bruinformula/mk11-shutdown-pcb/Shutdown-MX150L.step

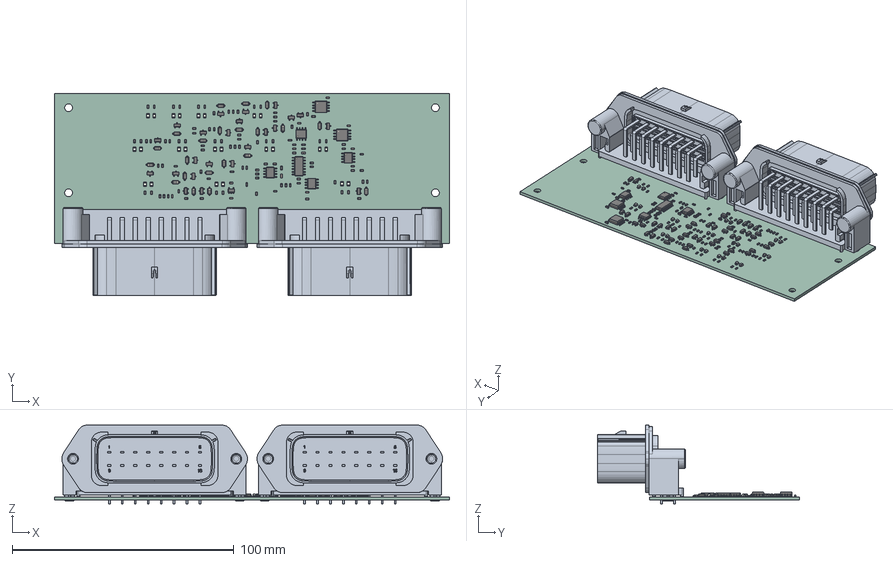
[picture p1: CAD file, 2026-02-07]
Shutdown-MX150L.step
178.3 x 91.0 x 35.6 mm
R_0603_1608Metric x 94
LED_0805_2012Metric x 24
D_SOD-123 x 21
SOT-23-3 x 23
SOIC-8_3.9x4.9mm_P1.27mm x 4
C_0603_1608Metric x 13
SOIC-14_3.9x8.7mm_P1.27mm
SOIC-8_5.3x5.3mm_P1.27mm x 2
SOT-23-5
Shutdown_PCB
