bruinformula/mk11-shutdown-pcb/Project-Libraries/3D Models/0194270049.stp

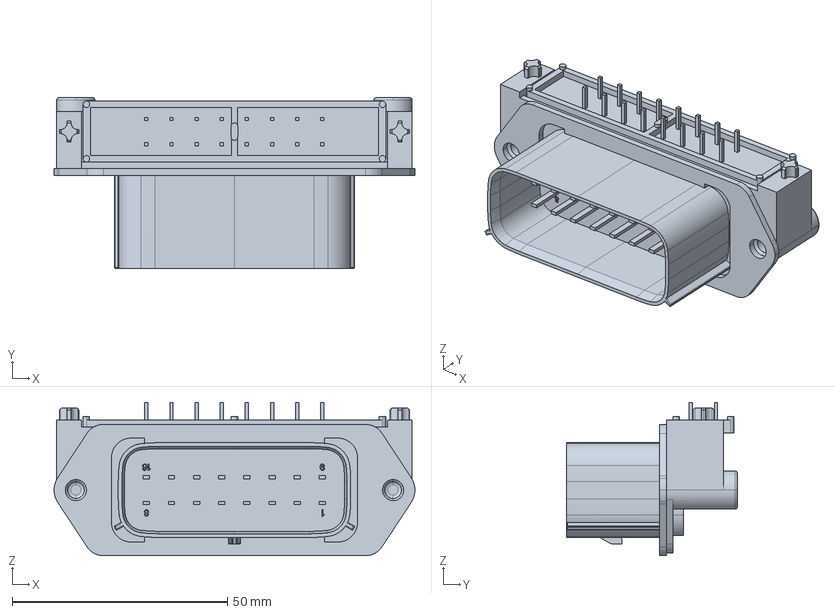
[picture p2: CAD file, 2026-02-07]
Project-Libraries/3D Models/0194270049.stp
83.8 x 39.6 x 35.6 mm
