bruinformula/mk11-shutdown-pcb/Project-Libraries/3D Models/348300801.stp

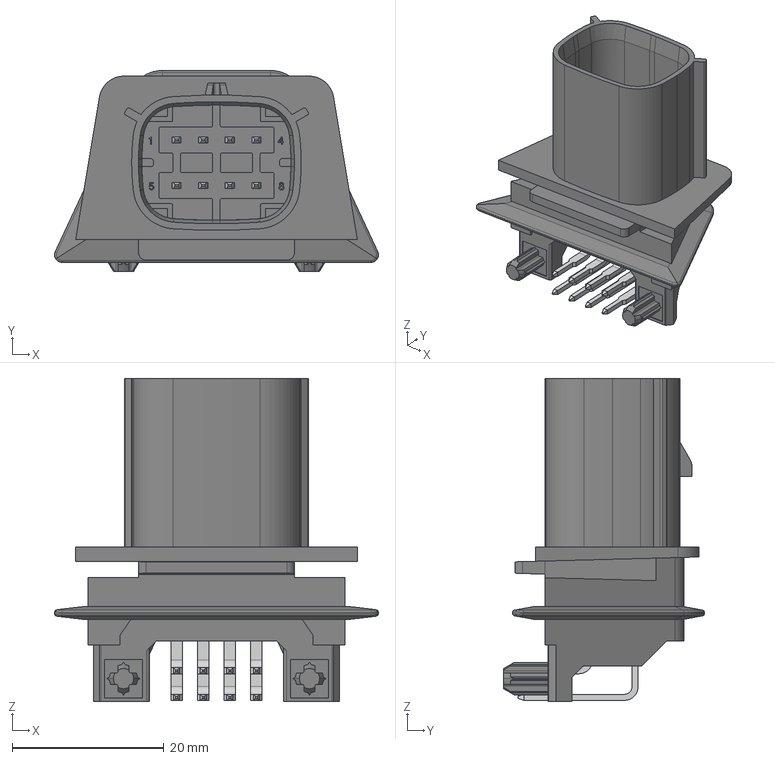
[picture p3: CAD file, 2025-10-08]
Project-Libraries/3D Models/348300801.stp
42.7 x 26.5 x 42.6 mm
