bruinformula/mk11-shutdown-pcb/Project-Libraries/3D Models/348302001.stp

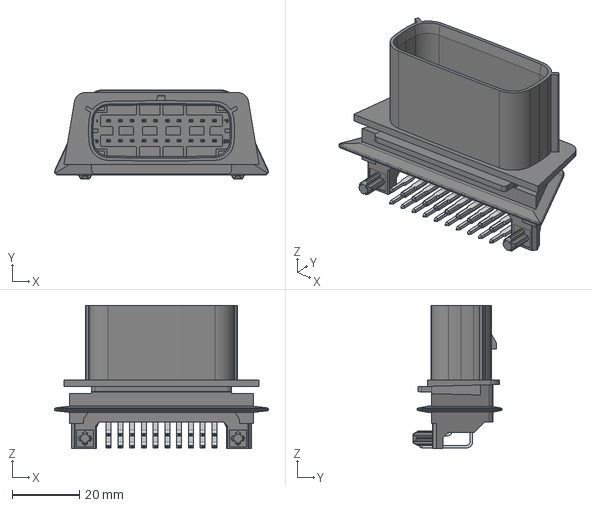
[picture p4: CAD file, 2025-10-08]
Project-Libraries/3D Models/348302001.stp
63.7 x 26.5 x 42.6 mm
