bruinformula/mk11-shutdown-pcb/Shutdown.kicad_pcb

## KiCad design Shutdown.kicad_pcb (2026-05-12)

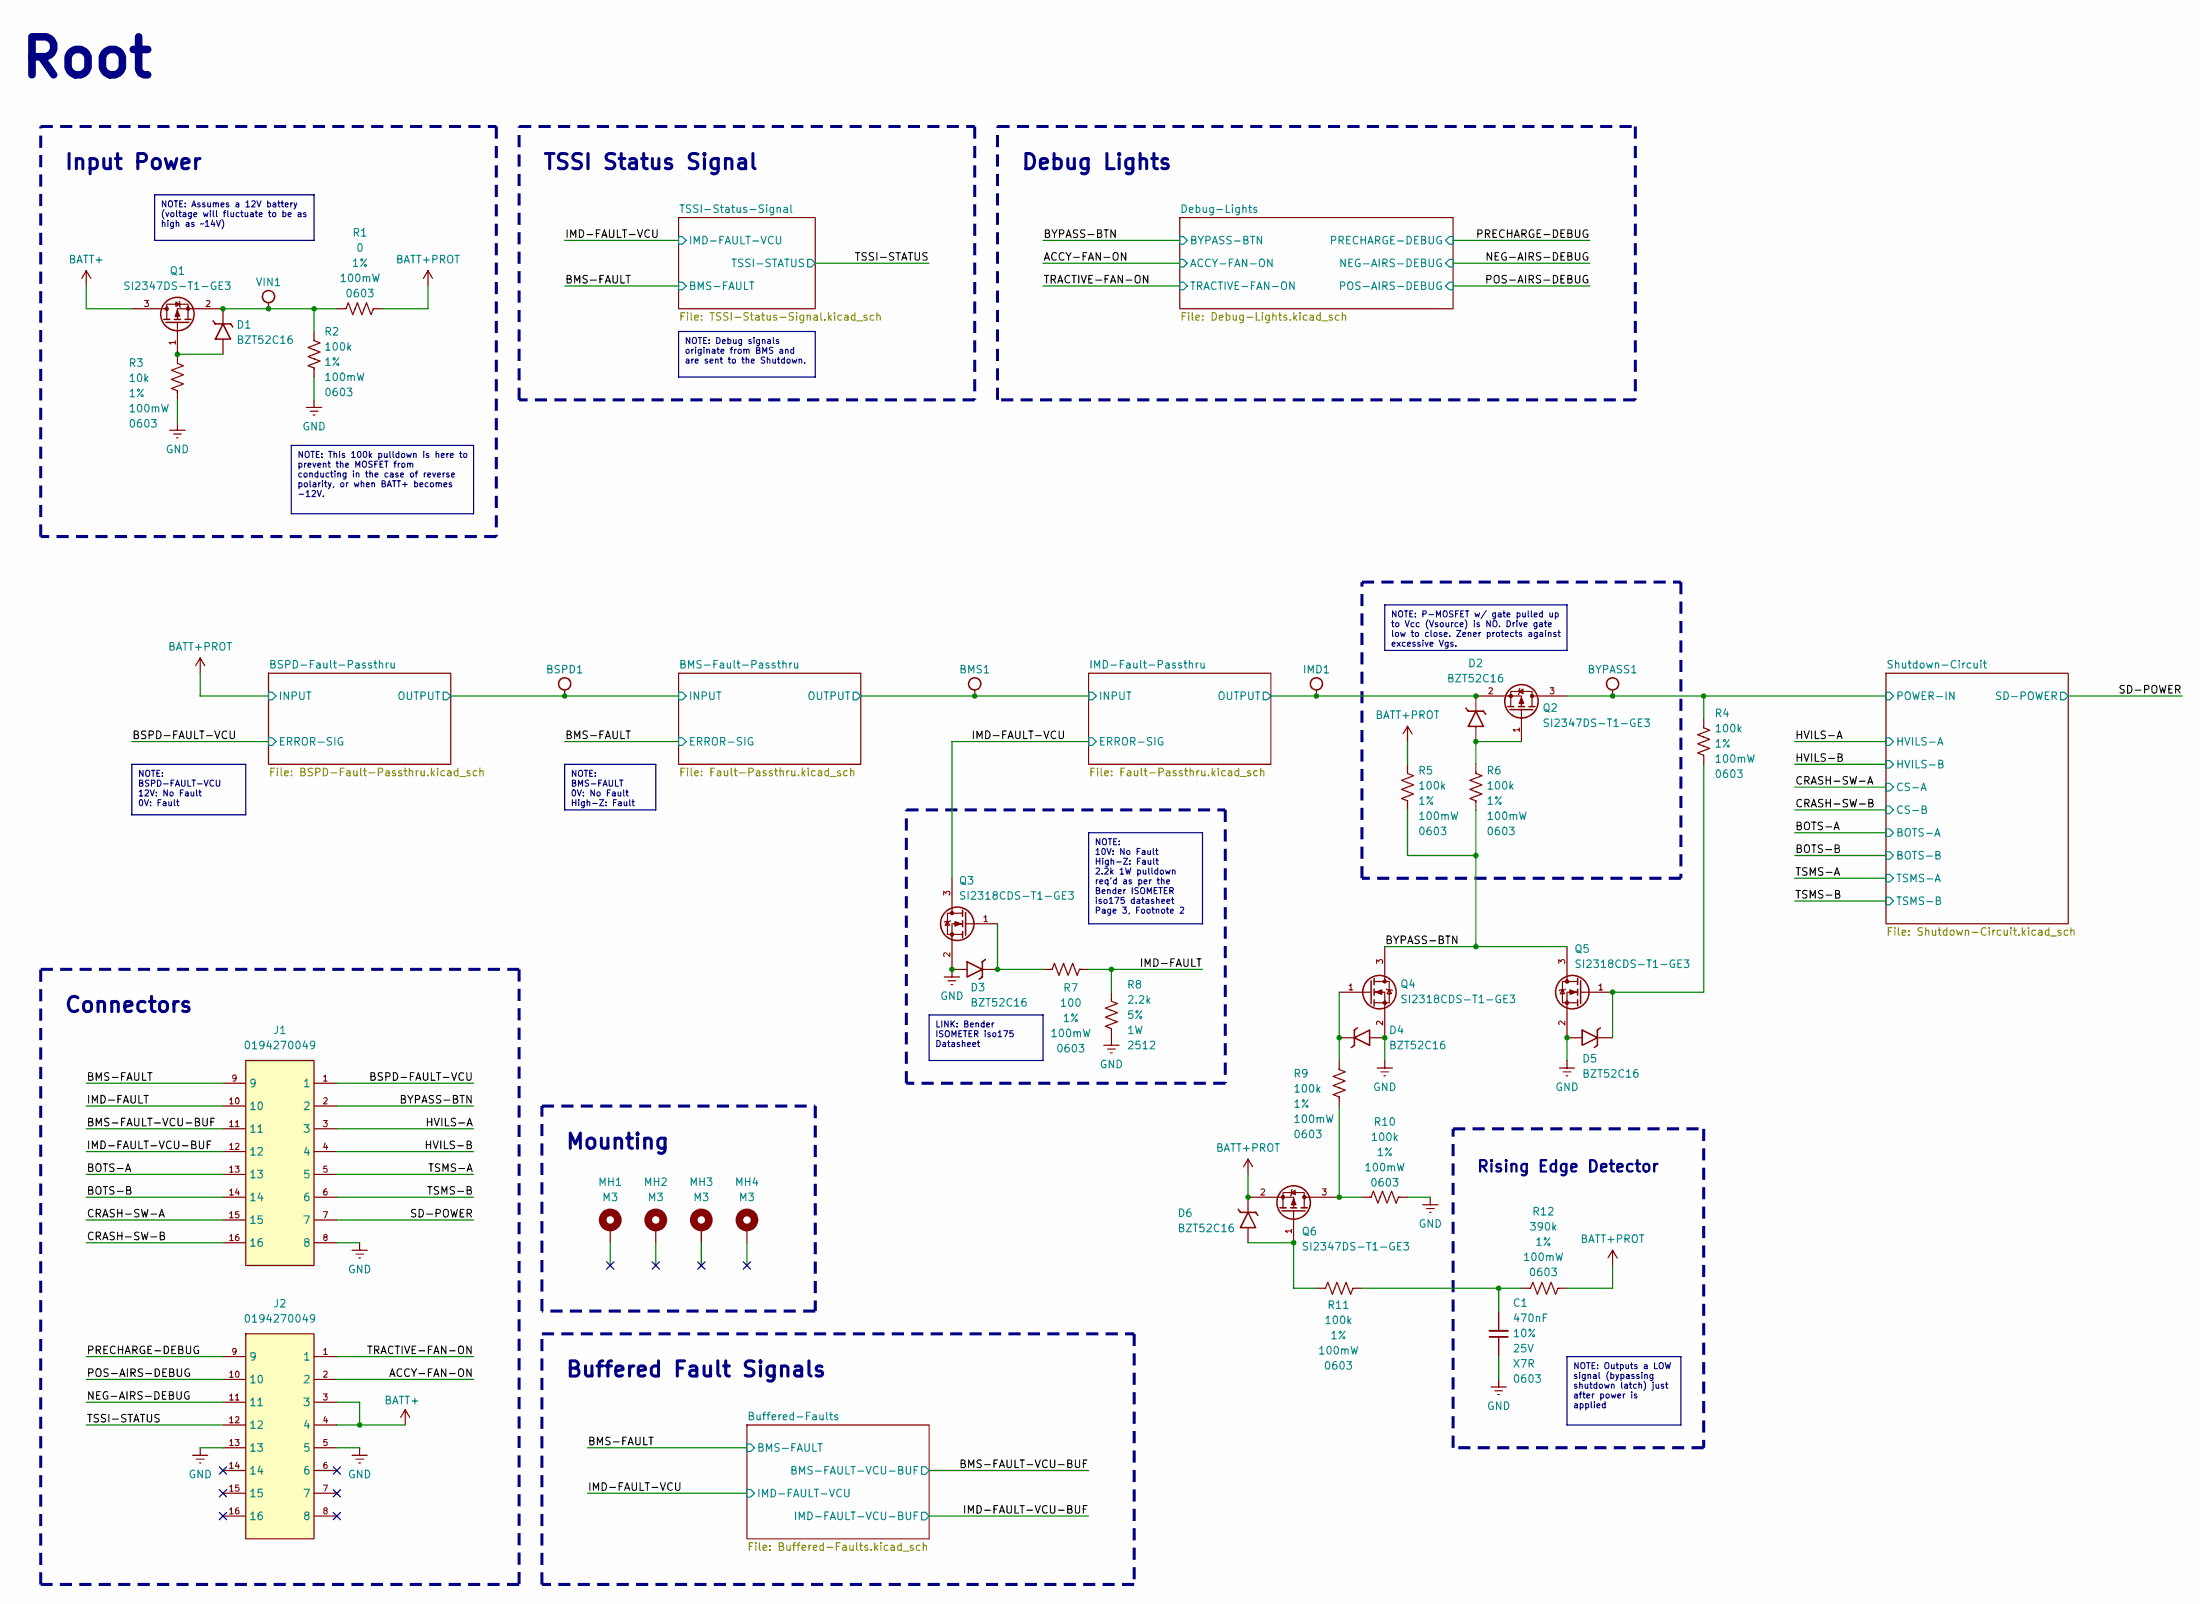
[picture p5: schematic Shutdown.kicad_sch]

Parts:
BMS1: TestPoint_Pad_1.0x1.0mm
BSPD1: TestPoint_Pad_1.0x1.0mm
BYPASS1: TestPoint_Pad_1.0x1.0mm
C1: 470nF; C_0603_1608Metric_Pad1.08x0.95mm_HandSolder; Tolerance 10%; Voltage 25V; Manufacturer P/N CL10B474KA8NNNC; Digikey P/N 1276-2083-1-ND
D1, D2, D3, D4, D5, D6: BZT52C16; D_SOD-123; Manufacturer P/N BZT52C16; Digikey P/N 4878-BZT52C16CT-ND
IMD1: TestPoint_Pad_1.0x1.0mm
J1, J2: 0194270049; Manufacturer P/N 0194270049; Digikey P/N WM7385-ND
MH1, MH2, MH3, MH4: MountingHole_3.5mm_Pad_TopBottom
Q1, Q2, Q6: SI2347DS-T1-GE3; SOT-23-3; Manufacturer P/N SI2347DS-T1-GE3; Digikey P/N SI2347DS-T1-GE3CT-ND
Q3, Q4, Q5: SI2318CDS-T1-GE3; SOT-23-3; Manufacturer P/N SI2318CDS-T1-GE3; Digikey P/N SI2318CDS-T1-GE3CT-ND
R1: 0; R_0603_1608Metric_Pad0.98x0.95mm_HandSolder; Tolerance 1%; Power Rating 100mW; Manufacturer P/N 0603WAF0000T5E; Digikey P/N 311-0.0GRCT-ND
R2, R4, R5, R6, R9, R10, R11: 100k; R_0603_1608Metric_Pad0.98x0.95mm_HandSolder; Tolerance 1%; Power Rating 100mW; Manufacturer P/N 0603WAF1003T5E; Digikey P/N RG16P100KBCT-ND
R3: 10k; R_0603_1608Metric_Pad0.98x0.95mm_HandSolder; Tolerance 1%; Power Rating 100mW; Manufacturer P/N 0603WAF1002T5E; Digikey P/N 541-10.0KHCT-ND
R7: 100; R_0603_1608Metric_Pad0.98x0.95mm_HandSolder; Tolerance 1%; Power Rating 100mW; Manufacturer P/N 0603WAF1000T5E; Digikey P/N 311-100HRCT-ND
R8: 2.2k; R_2512_6332Metric_Pad1.40x3.35mm_HandSolder; Tolerance 5%; Power Rating 1W; Manufacturer P/N FRC2512J222 TS; Digikey P/N RMCF2512JT2K20CT-ND
R12: 390k; R_0603_1608Metric_Pad0.98x0.95mm_HandSolder; Tolerance 1%; Power Rating 100mW; Manufacturer P/N 0603WAF3903T5E; Digikey P/N 311-390KHRCT-ND
VIN1: TestPoint_Pad_1.0x1.0mm

Connections:
/ACCY-FAN-ON: J2.2; also elsewhere on the board
/BMS-FAULT: J1.9; also elsewhere on the board
/BMS-FAULT-VCU-BUF: J1.11; also elsewhere on the board
/BMS-Fault-Passthru/INPUT: BSPD1.1 (1_1); also elsewhere on the board
/BMS-Fault-Passthru/OUTPUT: BMS1.1 (1_1); also elsewhere on the board
/BOTS-A: J1.13, J1.16; also elsewhere on the board
/BOTS-B: J1.5, J1.14; also elsewhere on the board
/BSPD-FAULT-VCU: J1.1; also elsewhere on the board
/BYPASS-BTN: J1.2, Q4.3 (D), Q5.3 (D), R5.1, R6.1; also elsewhere on the board
/CRASH-SW-A: J1.4, J1.15; also elsewhere on the board
/HVILS-A: BYPASS1.1 (1_1), J1.3, Q2.3 (D), R4.2; also elsewhere on the board
/IMD-FAULT: J1.10, R7.2, R8.2
/IMD-FAULT-VCU: Q3.3 (D); also elsewhere on the board
/IMD-FAULT-VCU-BUF: J1.12; also elsewhere on the board
/IMD-Fault-Passthru/OUTPUT: D2.1 (K), IMD1.1 (1_1), Q2.2 (S); also elsewhere on the board
/NEG-AIRS-DEBUG: J2.11; also elsewhere on the board
/POS-AIRS-DEBUG: J2.10; also elsewhere on the board
/PRECHARGE-DEBUG: J2.9; also elsewhere on the board
/SD-POWER: J1.6, J1.7; also elsewhere on the board
/TRACTIVE-FAN-ON: J2.1; also elsewhere on the board
/TSSI-STATUS: J2.12; also elsewhere on the board
BATT+: J2.3, J2.4, Q1.3 (D); also elsewhere on the board
BATT+PROT: D6.1 (K), Q6.2 (S), R1.2, R5.2, R12.2; also elsewhere on the board
GND: C1.1, D3.2 (A), D4.2 (A), D5.2 (A), J1.8, J2.5, J2.13, Q3.2 (S), Q4.2 (S), Q5.2 (S), R2.1, R3.1, R8.1, R10.2; also elsewhere on the board
unnamed: C1.2, R11.2, R12.1
unnamed: D1.2 (A), Q1.1 (G), R3.2
unnamed: D1.1 (K), Q1.2 (S), R1.1, R2.2, VIN1.1 (1_1)
unnamed: D2.2 (A), Q2.1 (G), R6.2
unnamed: D3.1 (K), Q3.1 (G), R7.1
unnamed: D4.1 (K), Q4.1 (G), R9.2
unnamed: D5.1 (K), Q5.1 (G), R4.1
unnamed: D6.2 (A), Q6.1 (G), R11.1
unnamed: Q6.3 (D), R9.1, R10.1

Notes on the sheet:
Buffered Fault Signals
Input Power
Rising Edge Detector
Debug Lights
Root
Mounting
TSSI Status Signal
Connectors
LINK: Bender ISOMETER iso175 Datasheet
NOTE: This 100k pulldown is here to prevent the MOSFET from conducting in the case of reverse polarity, or when BATT+ becomes -12V.
NOTE: Assumes a 12V battery (voltage will fluctuate to be as high as ~14V)
NOTE: Debug signals originate from BMS and are sent to the Shutdown.
NOTE: P-MOSFET w/ gate pulled up to Vcc (Vsource) is NO. Drive gate low to close. Zener protects against excessive Vgs.
NOTE: BSPD-FAULT-VCU 12V: No Fault 0V: Fault
NOTE: BMS-FAULT 0V: No Fault High-Z: Fault
NOTE: Outputs a LOW signal (bypassing shutdown latch) just after power is applied
NOTE: 10V: No Fault High-Z: Fault 2.2k 1W pulldown req'd as per the Bender ISOMETER iso175 datasheet Page 3, Footnote 2

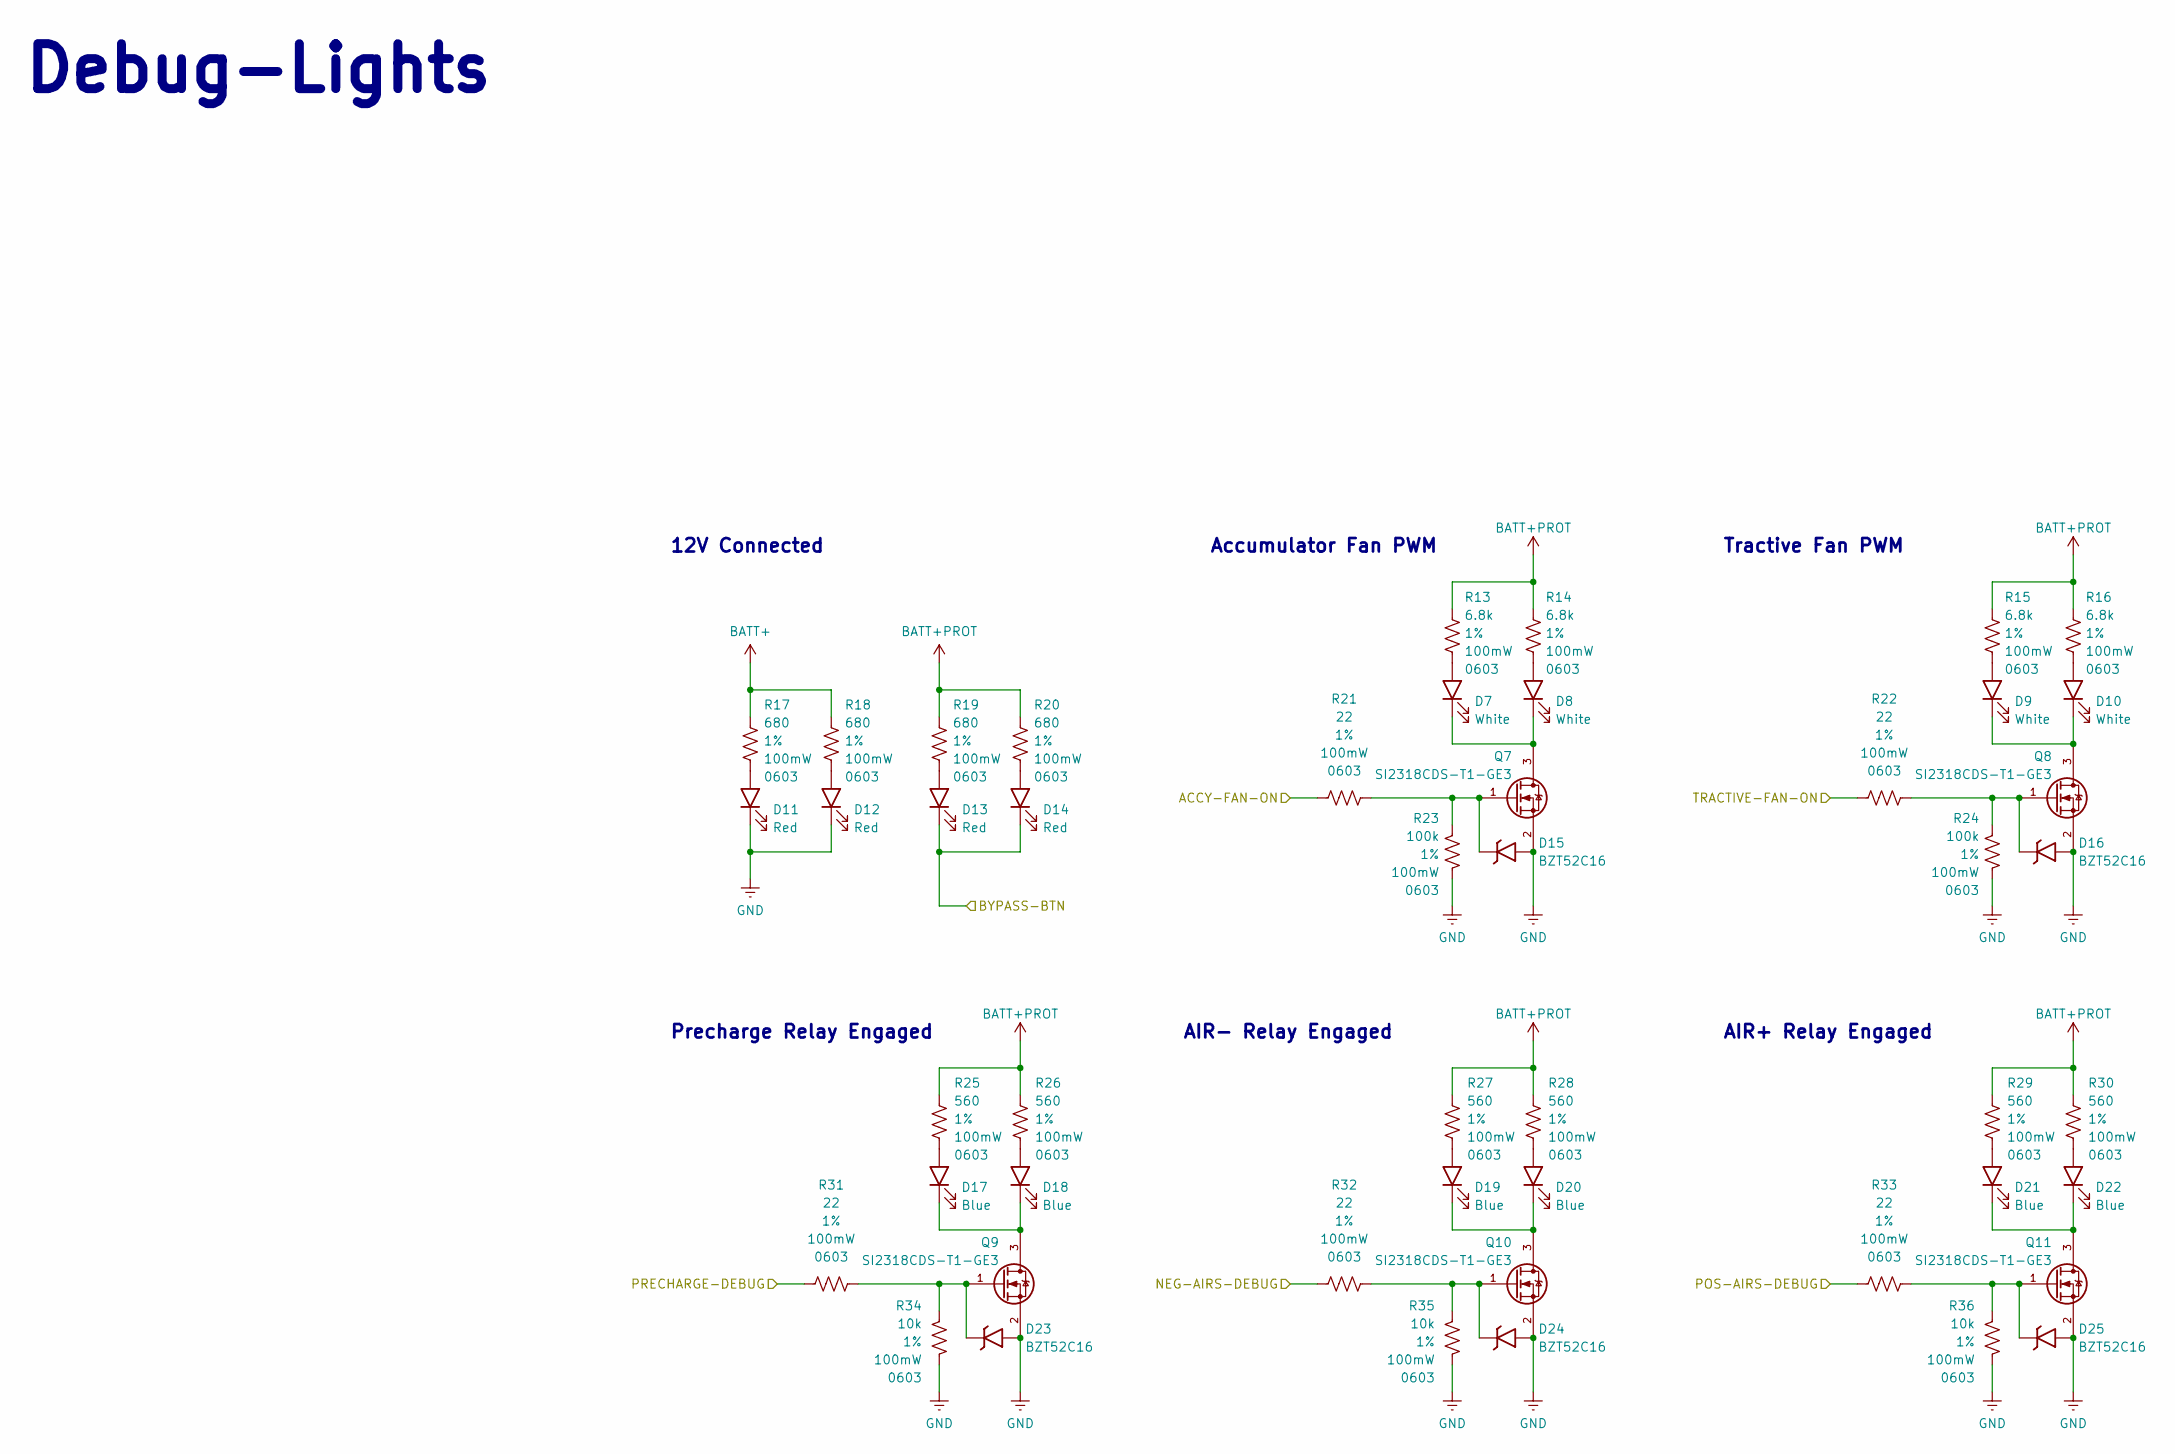
[picture p6: schematic Debug-Lights.kicad_sch]

Parts:
D7, D8, D9, D10: White; LED_0805_2012Metric; Manufacturer P/N KT-0805W; Digikey P/N 160-1738-1-ND
D11, D12, D13, D14: Red; LED_0805_2012Metric; Manufacturer P/N NCD0805R1; Digikey P/N 160-1427-1-ND
D15, D16, D23, D24, D25: BZT52C16; D_SOD-123; Manufacturer P/N BZT52C16; Digikey P/N 4878-BZT52C16CT-ND
D17, D18, D19, D20, D21, D22: Blue; LED_0805_2012Metric; Manufacturer P/N NCD0805B2; Digikey P/N 160-1579-1-ND
Q7, Q8, Q9, Q10, Q11: SI2318CDS-T1-GE3; SOT-23-3; Manufacturer P/N SI2318CDS-T1-GE3; Digikey P/N SI2318CDS-T1-GE3CT-ND
R13, R14, R15, R16: 6.8k; R_0603_1608Metric_Pad0.98x0.95mm_HandSolder; Tolerance 1%; Power Rating 100mW; Manufacturer P/N 0603WAF6801T5E; Digikey P/N 311-6.80KHRCT-ND
R17, R18, R19, R20: 680; R_0603_1608Metric_Pad0.98x0.95mm_HandSolder; Tolerance 1%; Power Rating 100mW; Manufacturer P/N 0603WAF6800T5E; Digikey P/N 311-680GRCT-ND
R21, R22, R31, R32, R33: 22; R_0603_1608Metric_Pad0.98x0.95mm_HandSolder; Tolerance 1%; Power Rating 100mW; Manufacturer P/N 0603WAF220JT5E; Digikey P/N 13-RC0603FR-1322RLCT-ND
R23, R24: 100k; R_0603_1608Metric_Pad0.98x0.95mm_HandSolder; Tolerance 1%; Power Rating 100mW; Manufacturer P/N 0603WAF1003T5E; Digikey P/N RG16P100KBCT-ND
R25, R26, R27, R28, R29, R30: 560; R_0603_1608Metric_Pad0.98x0.95mm_HandSolder; Tolerance 1%; Power Rating 100mW; Manufacturer P/N 0603WAF5600T5E; Digikey P/N 311-560HRCT-ND
R34, R35, R36: 10k; R_0603_1608Metric_Pad0.98x0.95mm_HandSolder; Tolerance 1%; Power Rating 100mW; Manufacturer P/N 0603WAF1002T5E; Digikey P/N 541-10.0KHCT-ND

Connections:
/ACCY-FAN-ON: R21.1; also elsewhere on the board
/BYPASS-BTN: D13.1 (K), D14.1 (K); also elsewhere on the board
/NEG-AIRS-DEBUG: R32.1; also elsewhere on the board
/POS-AIRS-DEBUG: R33.1; also elsewhere on the board
/PRECHARGE-DEBUG: R31.1; also elsewhere on the board
/TRACTIVE-FAN-ON: R22.1; also elsewhere on the board
BATT+: R17.2, R18.2; also elsewhere on the board
BATT+PROT: R13.2, R14.2, R15.2, R16.2, R19.2, R20.2, R25.2, R26.2, R27.2, R28.2, R29.2, R30.2; also elsewhere on the board
GND: D11.1 (K), D12.1 (K), D15.2 (A), D16.2 (A), D23.2 (A), D24.2 (A), D25.2 (A), Q7.2 (S), Q8.2 (S), Q9.2 (S), Q10.2 (S), Q11.2 (S), R23.1, R24.1, R34.1, R35.1, R36.1; also elsewhere on the board
unnamed: D7.2 (A), R13.1
unnamed: D7.1 (K), D8.1 (K), Q7.3 (D)
unnamed: D8.2 (A), R14.1
unnamed: D9.2 (A), R15.1
unnamed: D10.2 (A), R16.1
unnamed: D9.1 (K), D10.1 (K), Q8.3 (D)
unnamed: D11.2 (A), R17.1
unnamed: D12.2 (A), R18.1
unnamed: D13.2 (A), R19.1
unnamed: D14.2 (A), R20.1
unnamed: D15.1 (K), Q7.1 (G), R21.2, R23.2
unnamed: D16.1 (K), Q8.1 (G), R22.2, R24.2
unnamed: D17.2 (A), R25.1
unnamed: D17.1 (K), D18.1 (K), Q9.3 (D)
unnamed: D18.2 (A), R26.1
unnamed: D19.2 (A), R27.1
unnamed: D19.1 (K), D20.1 (K), Q10.3 (D)
unnamed: D20.2 (A), R28.1
unnamed: D21.2 (A), R29.1
unnamed: D21.1 (K), D22.1 (K), Q11.3 (D)
unnamed: D22.2 (A), R30.1
unnamed: D23.1 (K), Q9.1 (G), R31.2, R34.2
unnamed: D24.1 (K), Q10.1 (G), R32.2, R35.2
unnamed: D25.1 (K), Q11.1 (G), R33.2, R36.2

Notes on the sheet:
Debug-Lights
AIR+ Relay Engaged
Accumulator Fan PWM
Tractive Fan PWM
12V Connected
AIR- Relay Engaged
Precharge Relay Engaged

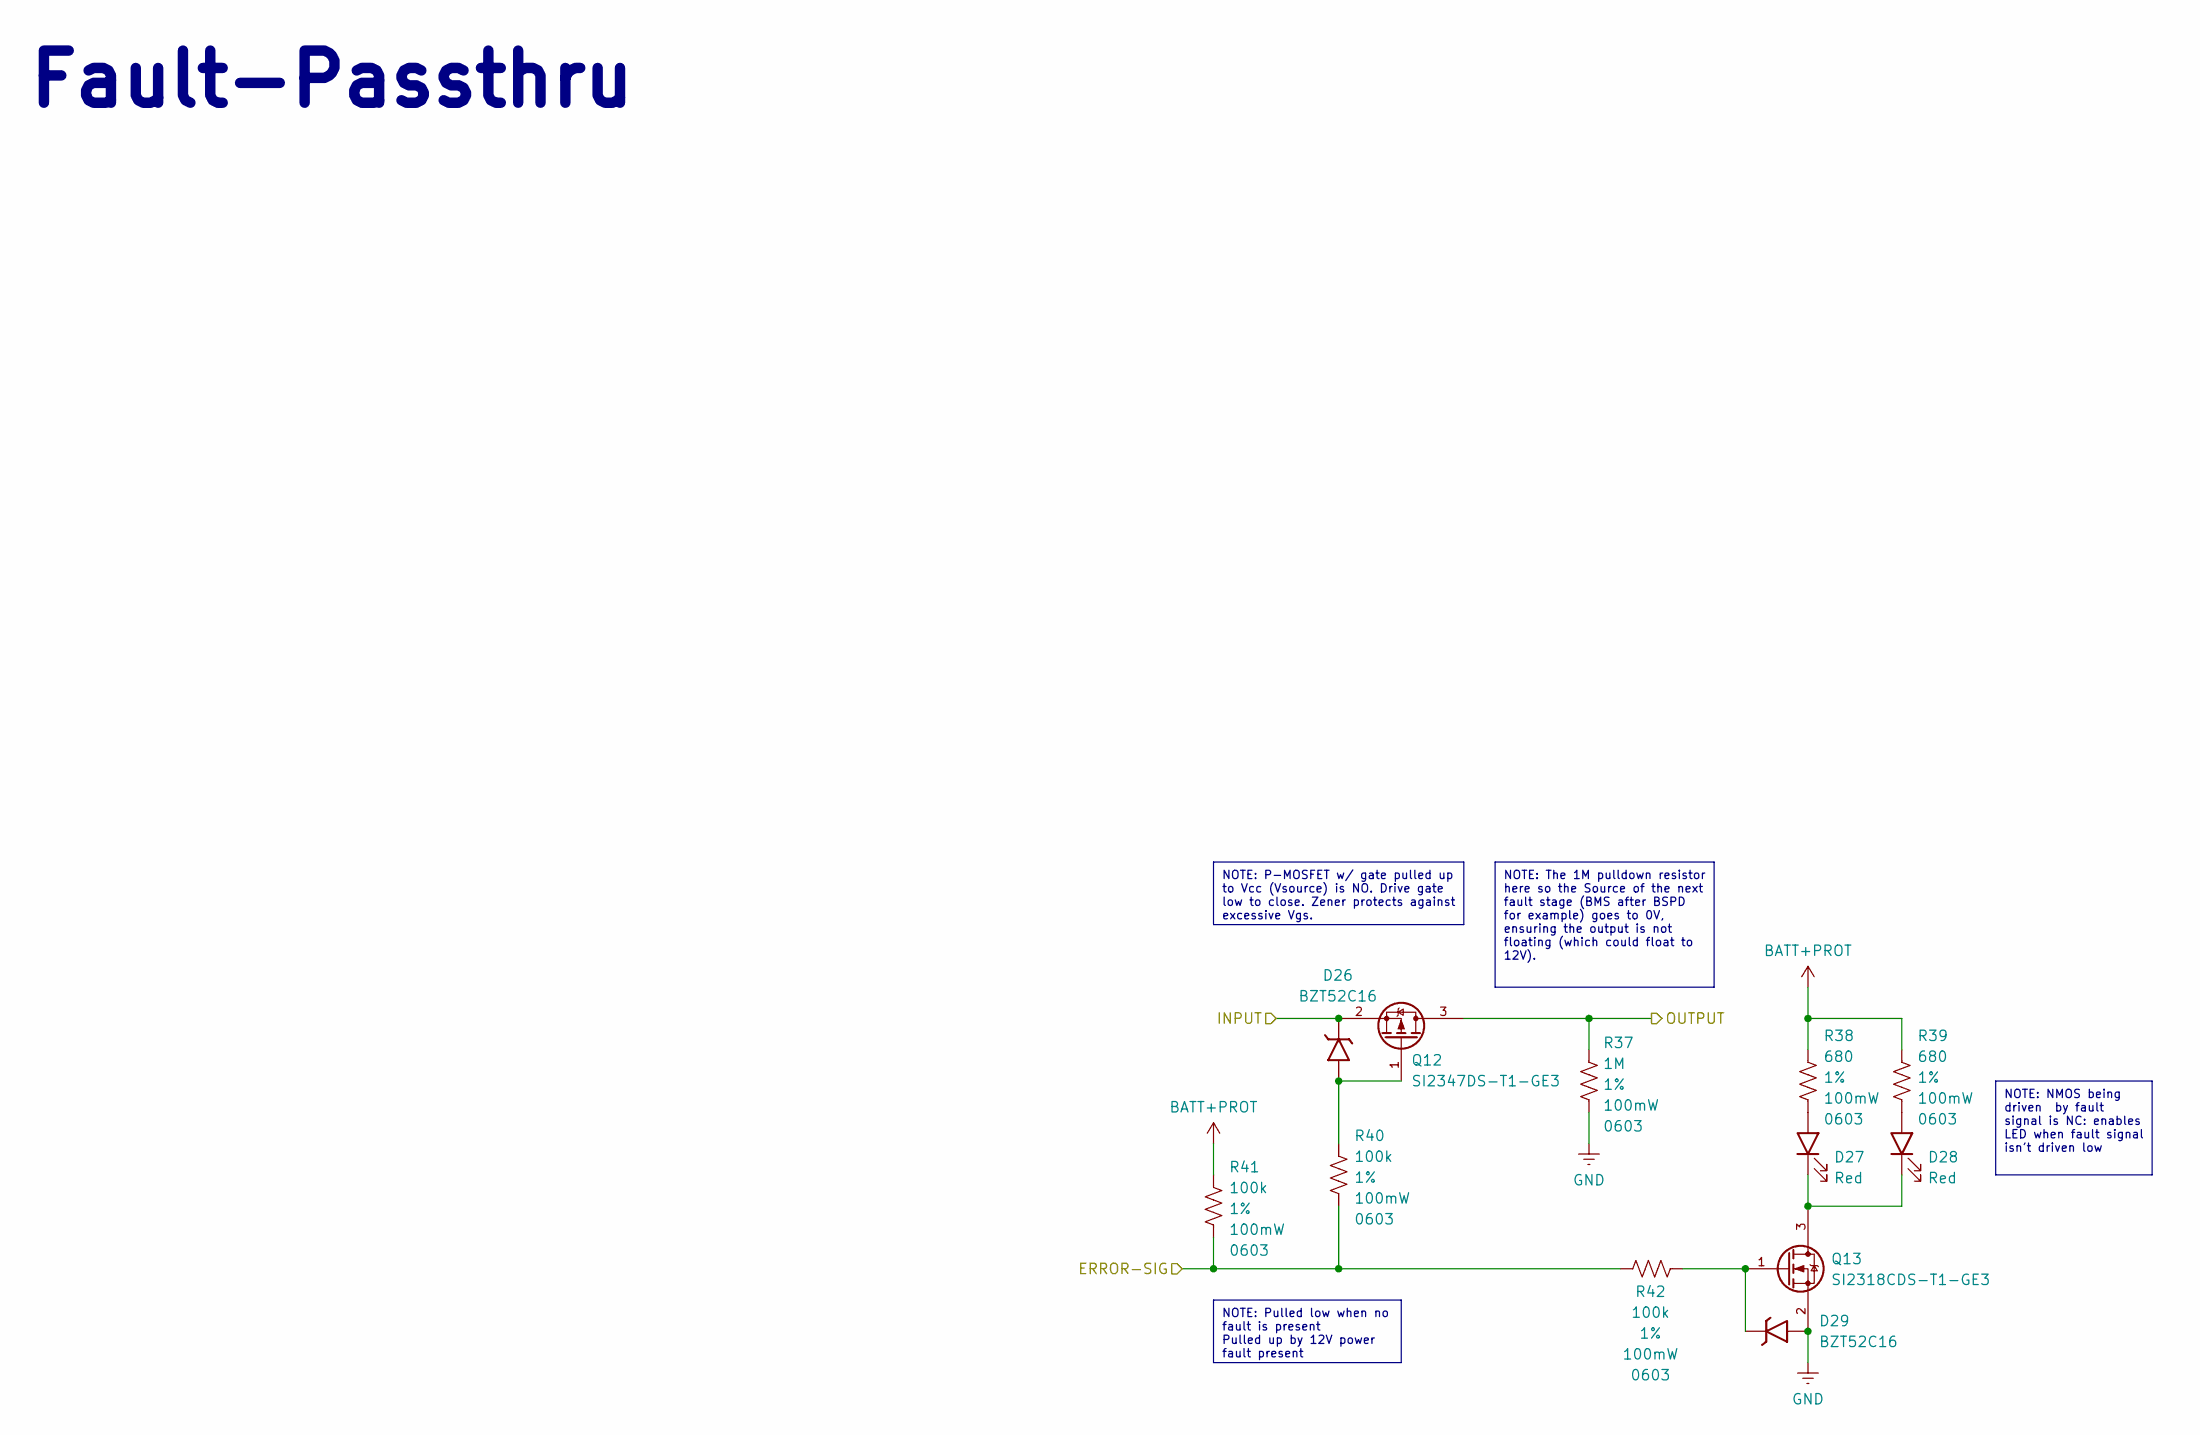
[picture p7: schematic Fault-Passthru.kicad_sch]

Parts:
D26, D29: BZT52C16; D_SOD-123; Manufacturer P/N BZT52C16; Digikey P/N 4878-BZT52C16CT-ND
D27, D28: Red; LED_0805_2012Metric; Manufacturer P/N NCD0805R1; Digikey P/N 160-1427-1-ND
Q12: SI2347DS-T1-GE3; SOT-23-3; Manufacturer P/N SI2347DS-T1-GE3; Digikey P/N SI2347DS-T1-GE3CT-ND
Q13: SI2318CDS-T1-GE3; SOT-23-3; Manufacturer P/N SI2318CDS-T1-GE3; Digikey P/N SI2318CDS-T1-GE3CT-ND
R37: 1M; R_0603_1608Metric_Pad0.98x0.95mm_HandSolder; Tolerance 1%; Power Rating 100mW; Manufacturer P/N 0603WAF1004T5E; Digikey P/N YAG4498CT-ND
R38, R39: 680; R_0603_1608Metric_Pad0.98x0.95mm_HandSolder; Tolerance 1%; Power Rating 100mW; Manufacturer P/N 0603WAF6800T5E; Digikey P/N 311-680GRCT-ND
R40, R41, R42: 100k; R_0603_1608Metric_Pad0.98x0.95mm_HandSolder; Tolerance 1%; Power Rating 100mW; Manufacturer P/N 0603WAF1003T5E; Digikey P/N RG16P100KBCT-ND

Connections:
/BMS-FAULT: R40.1, R41.1, R42.1; also elsewhere on the board
/BMS-Fault-Passthru/INPUT: D26.1 (K), Q12.2 (S); also elsewhere on the board
/BMS-Fault-Passthru/OUTPUT: Q12.3 (D), R37.2; also elsewhere on the board
BATT+PROT: R38.2, R39.2, R41.2; also elsewhere on the board
GND: D29.2 (A), Q13.2 (S), R37.1; also elsewhere on the board
unnamed: D26.2 (A), Q12.1 (G), R40.2
unnamed: D27.2 (A), R38.1
unnamed: D27.1 (K), D28.1 (K), Q13.3 (D)
unnamed: D28.2 (A), R39.1
unnamed: D29.1 (K), Q13.1 (G), R42.2

Parts of its further copies:
D30, D33: BZT52C16; D_SOD-123; Manufacturer P/N BZT52C16; Digikey P/N 4878-BZT52C16CT-ND
D31, D32: Red; LED_0805_2012Metric; Manufacturer P/N NCD0805R1; Digikey P/N 160-1427-1-ND
Q14: SI2347DS-T1-GE3; SOT-23-3; Manufacturer P/N SI2347DS-T1-GE3; Digikey P/N SI2347DS-T1-GE3CT-ND
Q15: SI2318CDS-T1-GE3; SOT-23-3; Manufacturer P/N SI2318CDS-T1-GE3; Digikey P/N SI2318CDS-T1-GE3CT-ND
R43: 1M; R_0603_1608Metric_Pad0.98x0.95mm_HandSolder; Tolerance 1%; Power Rating 100mW; Manufacturer P/N 0603WAF1004T5E; Digikey P/N YAG4498CT-ND
R44, R45: 680; R_0603_1608Metric_Pad0.98x0.95mm_HandSolder; Tolerance 1%; Power Rating 100mW; Manufacturer P/N 0603WAF6800T5E; Digikey P/N 311-680GRCT-ND
R46, R47, R48: 100k; R_0603_1608Metric_Pad0.98x0.95mm_HandSolder; Tolerance 1%; Power Rating 100mW; Manufacturer P/N 0603WAF1003T5E; Digikey P/N RG16P100KBCT-ND

Connections of its further copies:
/BMS-Fault-Passthru/OUTPUT: D30.1 (K), Q14.2 (S); also elsewhere on the board
/IMD-FAULT-VCU: R46.1, R47.1, R48.1; also elsewhere on the board
/IMD-Fault-Passthru/OUTPUT: Q14.3 (D), R43.2; also elsewhere on the board
BATT+PROT: R44.2, R45.2, R47.2; also elsewhere on the board
GND: D33.2 (A), Q15.2 (S), R43.1; also elsewhere on the board
unnamed: D30.2 (A), Q14.1 (G), R46.2
unnamed: D31.2 (A), R44.1
unnamed: D31.1 (K), D32.1 (K), Q15.3 (D)
unnamed: D32.2 (A), R45.1
unnamed: D33.1 (K), Q15.1 (G), R48.2

Notes on the sheet:
Fault-Passthru
NOTE: Pulled low when no fault is present Pulled up by 12V power fault present
NOTE: The 1M pulldown resistor here so the Source of the next fault stage (BMS after BSPD for example) goes to 0V, ensuring the output is not floating (which could float to 12V).
NOTE: NMOS being driven by fault signal is NC: enables LED when fault signal isn't driven low
NOTE: P-MOSFET w/ gate pulled up to Vcc (Vsource) is NO. Drive gate low to close. Zener protects against excessive Vgs.

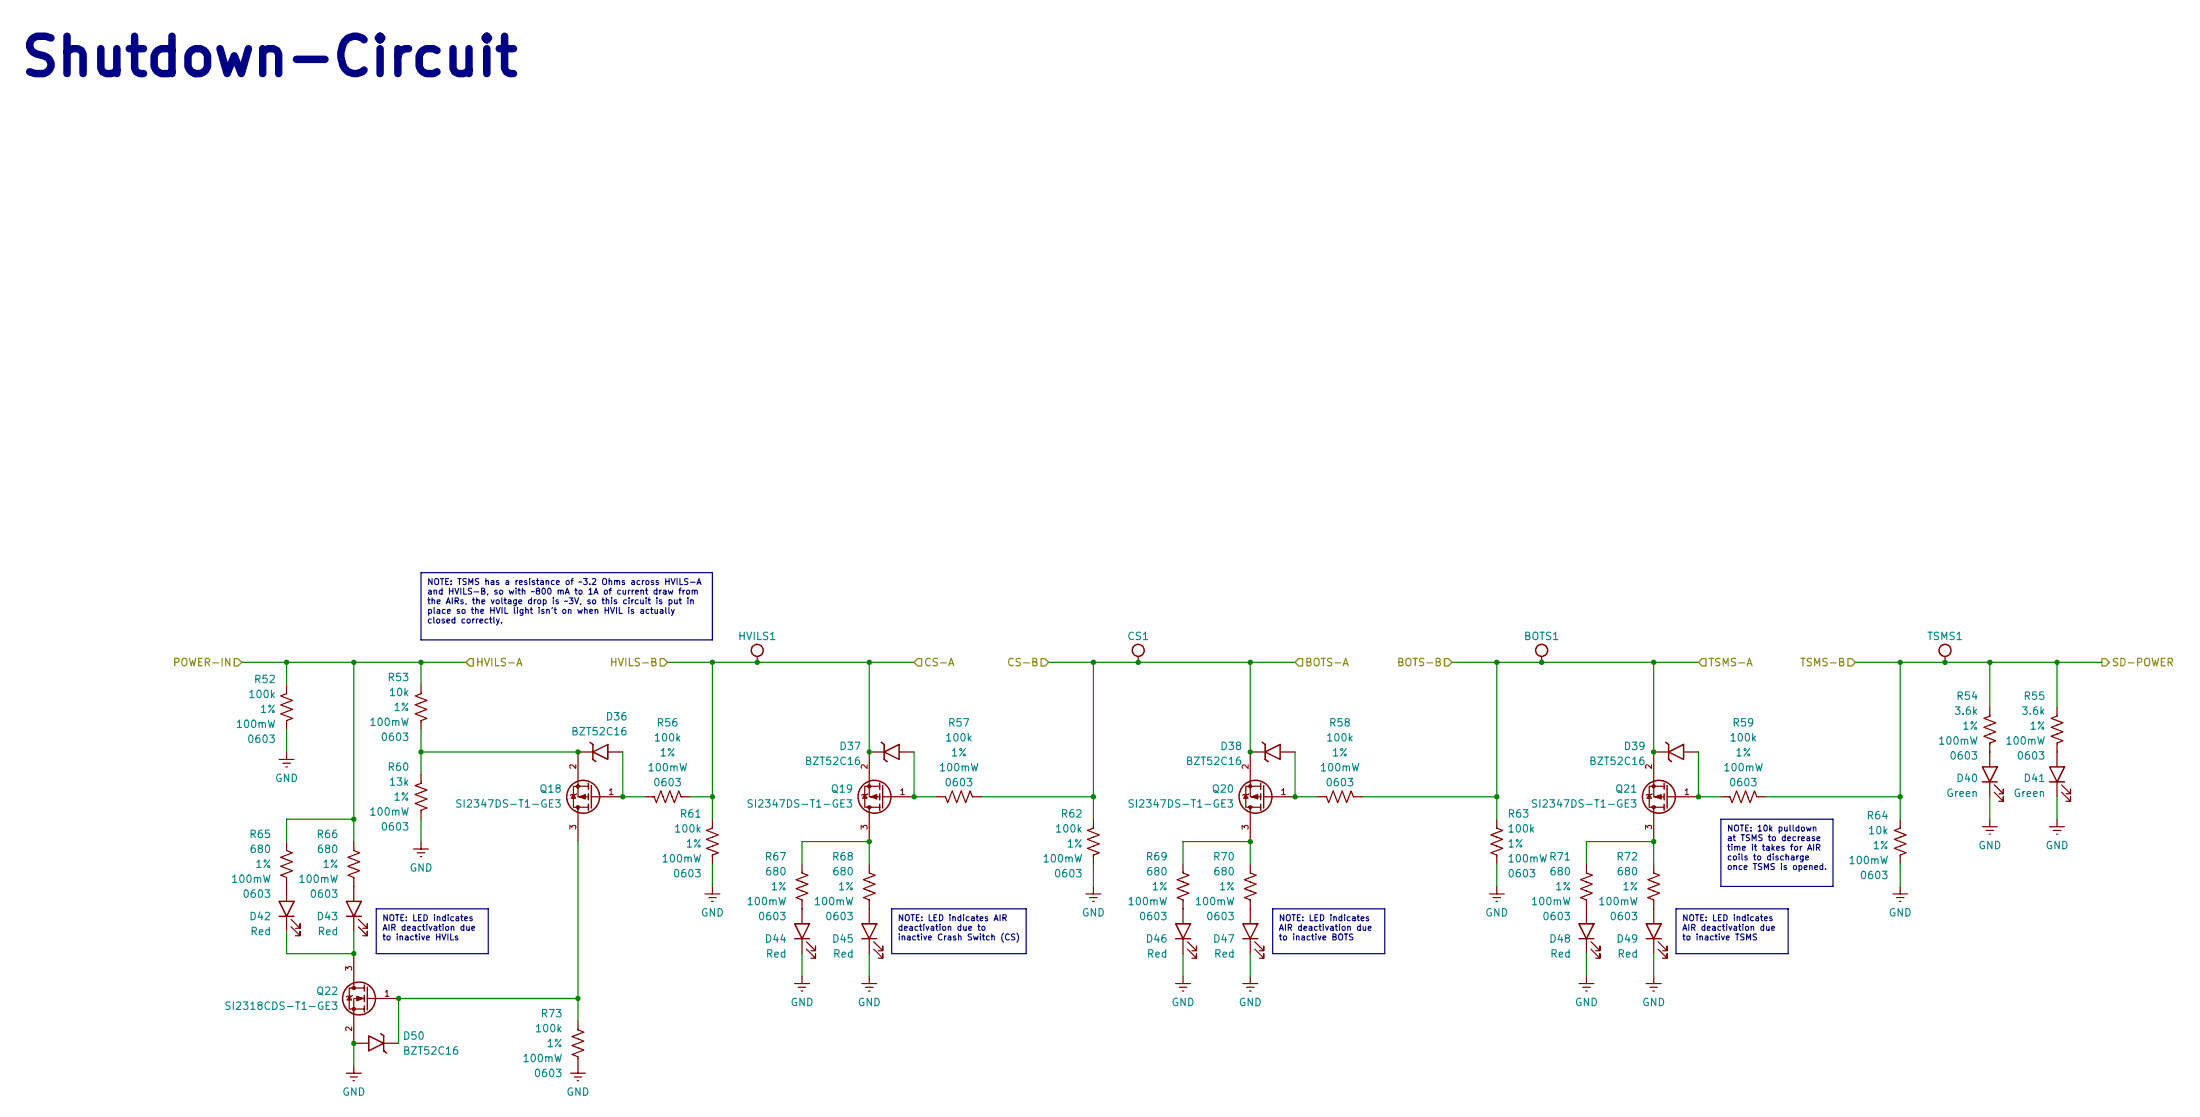
[picture p8: schematic Shutdown-Circuit.kicad_sch]

Parts:
BOTS1: BOTS; TestPoint_Pad_1.0x1.0mm
CS1: CS; TestPoint_Pad_1.0x1.0mm
D36, D37, D38, D39, D50: BZT52C16; D_SOD-123; Manufacturer P/N BZT52C16; Digikey P/N 4878-BZT52C16CT-ND
D40, D41: Green; LED_0805_2012Metric; Manufacturer P/N NCD0805G1; Digikey P/N 160-1426-1-ND
D42, D43, D44, D45, D46, D47, D48, D49: Red; LED_0805_2012Metric; Manufacturer P/N NCD0805R1; Digikey P/N 160-1427-1-ND
HVILS1: HVILS; TestPoint_Pad_1.0x1.0mm
Q18, Q19, Q20, Q21: SI2347DS-T1-GE3; SOT-23-3; Manufacturer P/N SI2347DS-T1-GE3; Digikey P/N SI2347DS-T1-GE3CT-ND
Q22: SI2318CDS-T1-GE3; SOT-23-3; Manufacturer P/N SI2318CDS-T1-GE3; Digikey P/N SI2318CDS-T1-GE3CT-ND
R52, R56, R57, R58, R59, R61, R62, R63, R73: 100k; R_0603_1608Metric_Pad0.98x0.95mm_HandSolder; Tolerance 1%; Power Rating 100mW; Manufacturer P/N 0603WAF1003T5E; Digikey P/N RG16P100KBCT-ND
R53, R64: 10k; R_0603_1608Metric_Pad0.98x0.95mm_HandSolder; Tolerance 1%; Power Rating 100mW; Manufacturer P/N 0603WAF1002T5E; Digikey P/N 541-10.0KHCT-ND
R54, R55: 3.6k; R_0603_1608Metric_Pad0.98x0.95mm_HandSolder; Tolerance 1%; Power Rating 100mW; Manufacturer P/N 0603WAF3601T5E; Digikey P/N 311-3.60KHRCT-ND
R60: 13k; R_0603_1608Metric_Pad0.98x0.95mm_HandSolder; Tolerance 1%; Power Rating 100mW; Manufacturer P/N 0603WAF1302T5E; Digikey P/N RMCF0603FT13K0CT-ND
R65, R66, R67, R68, R69, R70, R71, R72: 680; R_0603_1608Metric_Pad0.98x0.95mm_HandSolder; Tolerance 1%; Power Rating 100mW; Manufacturer P/N 0603WAF6800T5E; Digikey P/N 311-680GRCT-ND
TSMS1: TSMS; TestPoint_Pad_1.0x1.0mm

Connections:
/BOTS-A: CS1.1 (1_1), D38.1 (K), Q20.2 (S), R57.1, R62.2; also elsewhere on the board
/BOTS-B: BOTS1.1 (1_1), D39.1 (K), Q21.2 (S), R58.1, R63.2; also elsewhere on the board
/CRASH-SW-A: D37.1 (K), HVILS1.1 (1_1), Q19.2 (S), R56.1, R61.2; also elsewhere on the board
/HVILS-A: R52.2, R53.2, R65.2, R66.2; also elsewhere on the board
/SD-POWER: R54.2, R55.2, R59.1, R64.2, TSMS1.1 (1_1); also elsewhere on the board
GND: D40.1 (K), D41.1 (K), D44.1 (K), D45.1 (K), D46.1 (K), D47.1 (K), D48.1 (K), D49.1 (K), D50.2 (A), Q22.2 (S), R52.1, R60.1, R61.1, R62.1, R63.1, R64.1, R73.1; also elsewhere on the board
unnamed: D36.2 (A), Q18.1 (G), R56.2
unnamed: D36.1 (K), Q18.2 (S), R53.1, R60.2
unnamed: D37.2 (A), Q19.1 (G), R57.2
unnamed: D38.2 (A), Q20.1 (G), R58.2
unnamed: D39.2 (A), Q21.1 (G), R59.2
unnamed: D40.2 (A), R54.1
unnamed: D41.2 (A), R55.1
unnamed: D42.2 (A), R65.1
unnamed: D42.1 (K), D43.1 (K), Q22.3 (D)
unnamed: D43.2 (A), R66.1
unnamed: D44.2 (A), R67.1
unnamed: D45.2 (A), R68.1
unnamed: D46.2 (A), R69.1
unnamed: D47.2 (A), R70.1
unnamed: D48.2 (A), R71.1
unnamed: D49.2 (A), R72.1
unnamed: D50.1 (K), Q18.3 (D), Q22.1 (G), R73.2
unnamed: Q19.3 (D), R67.2, R68.2
unnamed: Q20.3 (D), R69.2, R70.2
unnamed: Q21.3 (D), R71.2, R72.2

Notes on the sheet:
Shutdown-Circuit
NOTE: 10k pulldown at TSMS to decrease time it takes for AIR coils to discharge once TSMS is opened.
NOTE: LED indicates AIR deactivation due to inactive HVILs
NOTE: LED indicates AIR deactivation due to inactive BOTS
NOTE: LED indicates AIR deactivation due to inactive Crash Switch (CS)
NOTE: LED indicates AIR deactivation due to inactive TSMS
NOTE: TSMS has a resistance of ~3.2 Ohms across HVILS-A and HVILS-B, so with ~800 mA to 1A of current draw from the AIRs, the voltage drop is ~3V, so this circuit is put in place so the HVIL light isn't on when HVIL is actually closed correctly.
