bruinformula/mk11-shutdown-pcb/Shutdown.kicad_pcb

## KiCad design Shutdown.kicad_pcb (continued)

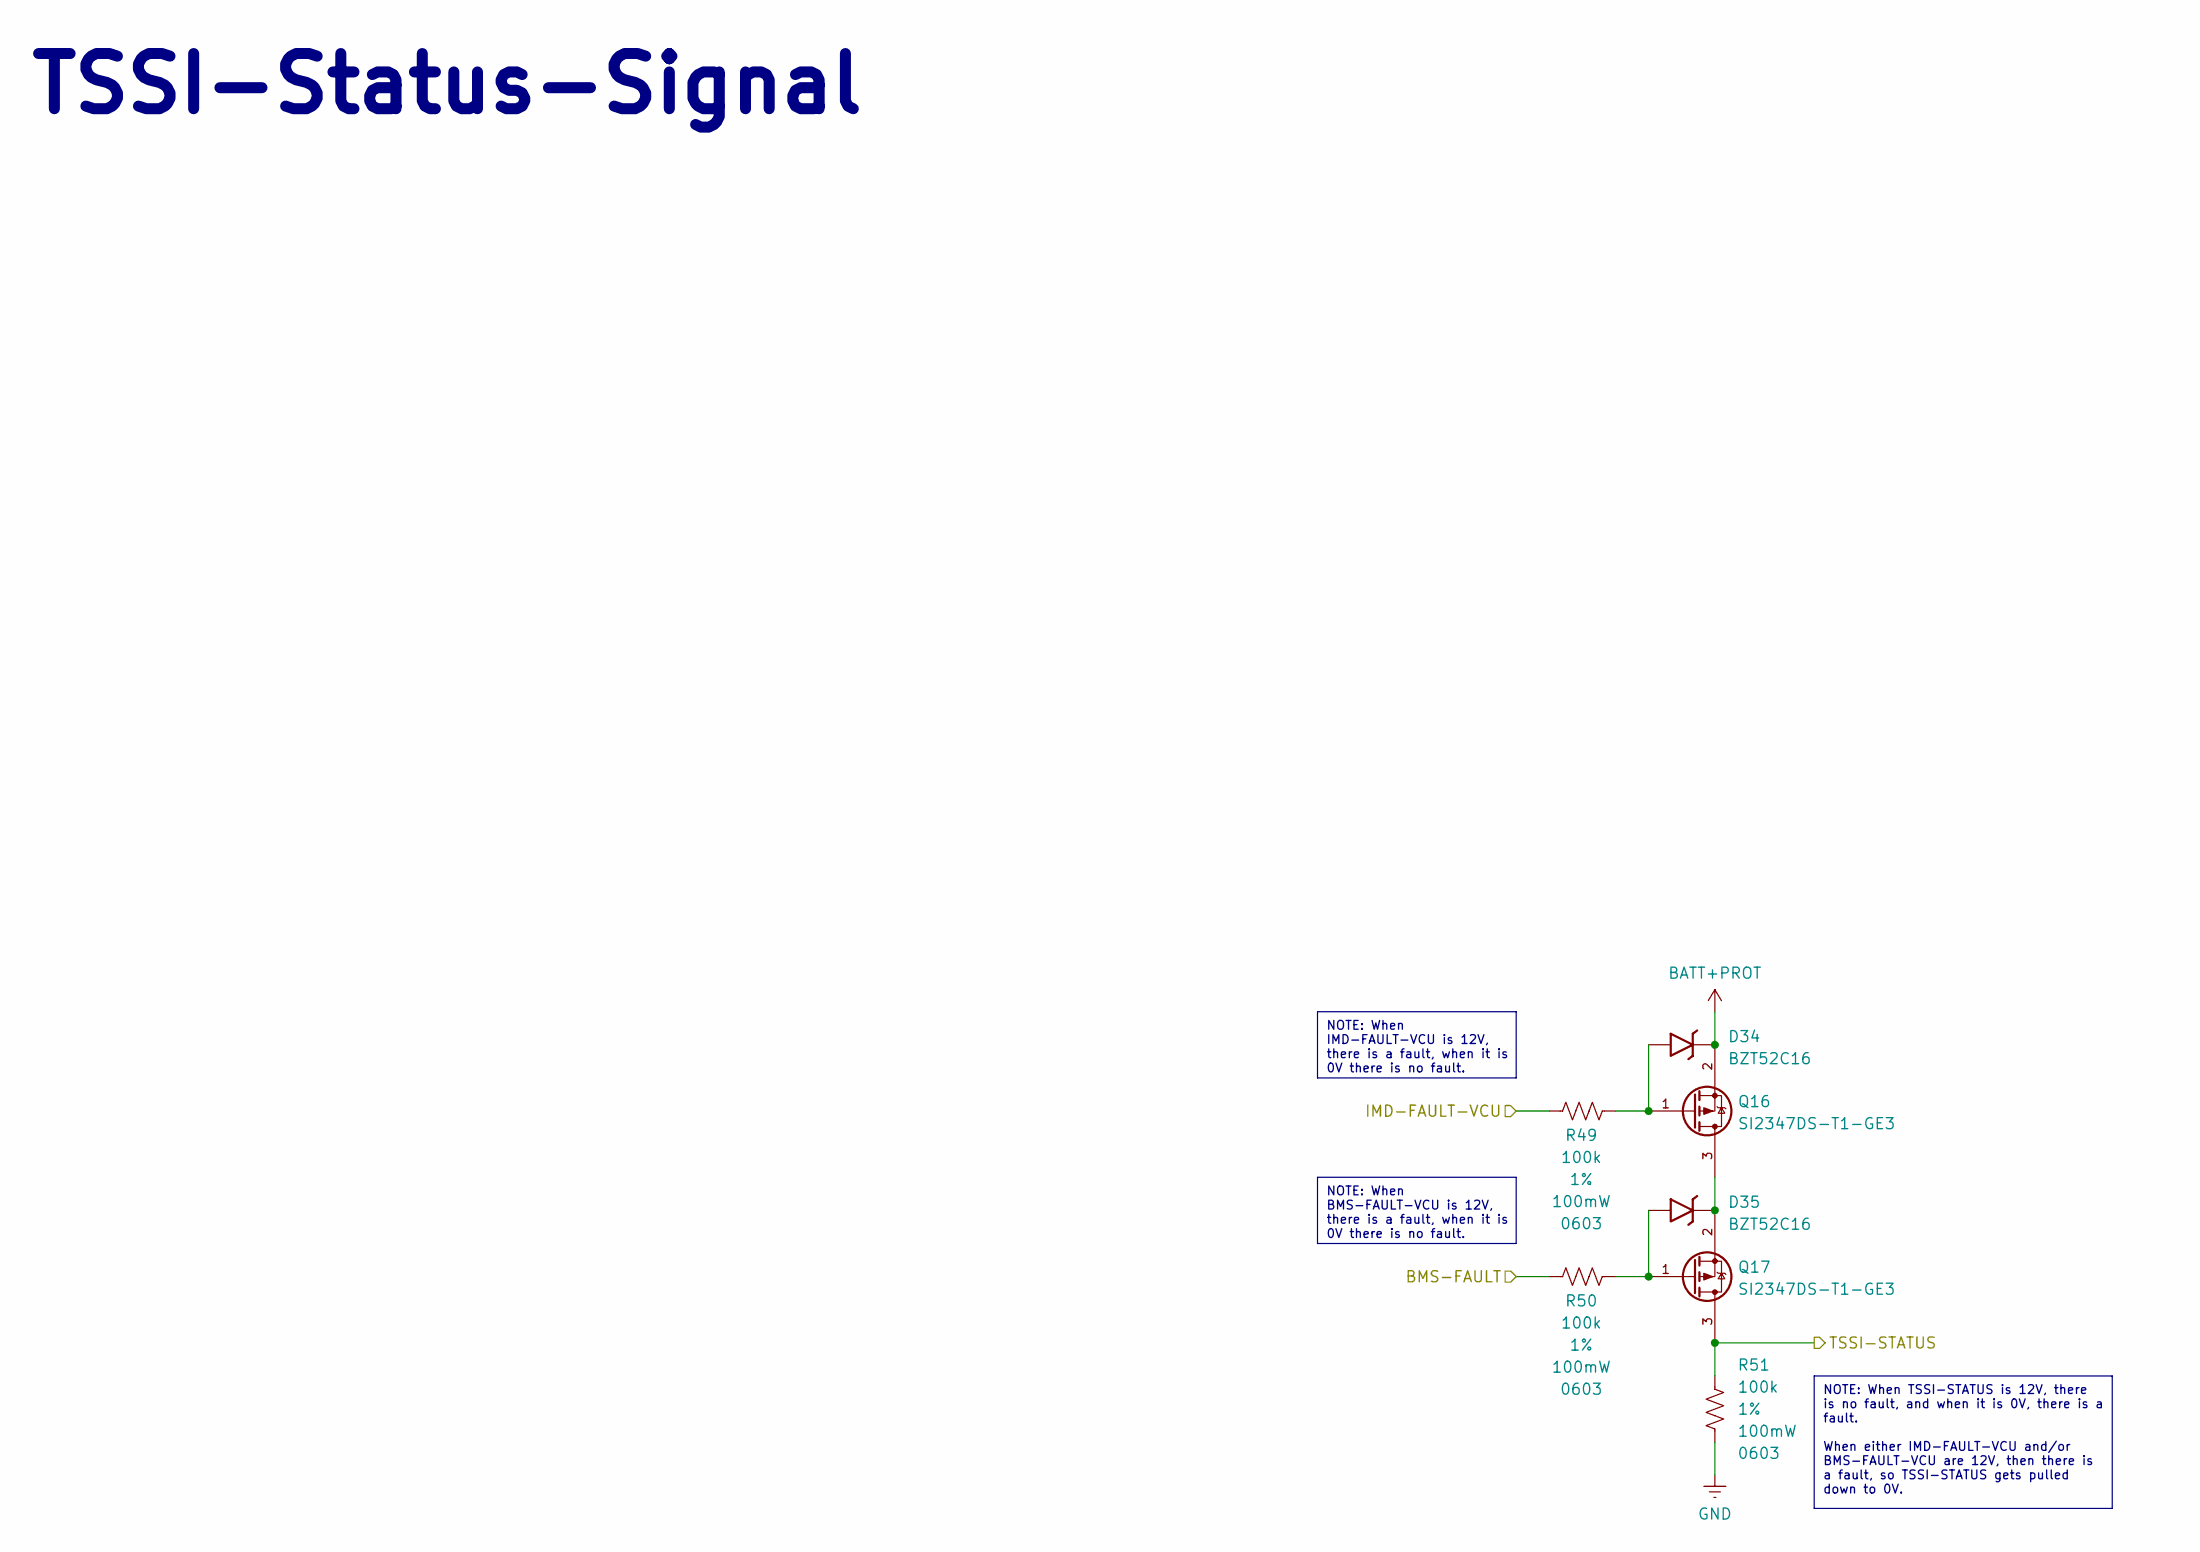
[picture p9: schematic TSSI-Status-Signal.kicad_sch]

Parts:
D34, D35: BZT52C16; D_SOD-123; Manufacturer P/N BZT52C16; Digikey P/N 4878-BZT52C16CT-ND
Q16, Q17: SI2347DS-T1-GE3; SOT-23-3; Manufacturer P/N SI2347DS-T1-GE3; Digikey P/N SI2347DS-T1-GE3CT-ND
R49, R50, R51: 100k; R_0603_1608Metric_Pad0.98x0.95mm_HandSolder; Tolerance 1%; Power Rating 100mW; Manufacturer P/N 0603WAF1003T5E; Digikey P/N RG16P100KBCT-ND

Connections:
/BMS-FAULT: R50.1; also elsewhere on the board
/IMD-FAULT-VCU: R49.1; also elsewhere on the board
/TSSI-STATUS: Q17.3 (D), R51.2; also elsewhere on the board
BATT+PROT: D34.1 (K), Q16.2 (S); also elsewhere on the board
GND: R51.1; also elsewhere on the board
unnamed: D34.2 (A), Q16.1 (G), R49.2
unnamed: D35.2 (A), Q17.1 (G), R50.2
unnamed: D35.1 (K), Q16.3 (D), Q17.2 (S)

Notes on the sheet:
TSSI-Status-Signal
NOTE: When IMD-FAULT-VCU is 12V, there is a fault, when it is 0V there is no fault.
NOTE: When TSSI-STATUS is 12V, there is no fault, and when it is 0V, there is a fault. When either IMD-FAULT-VCU and/or BMS-FAULT-VCU are 12V, then there is a fault, so TSSI-STATUS gets pulled down to 0V.
NOTE: When BMS-FAULT-VCU is 12V, there is a fault, when it is 0V there is no fault.

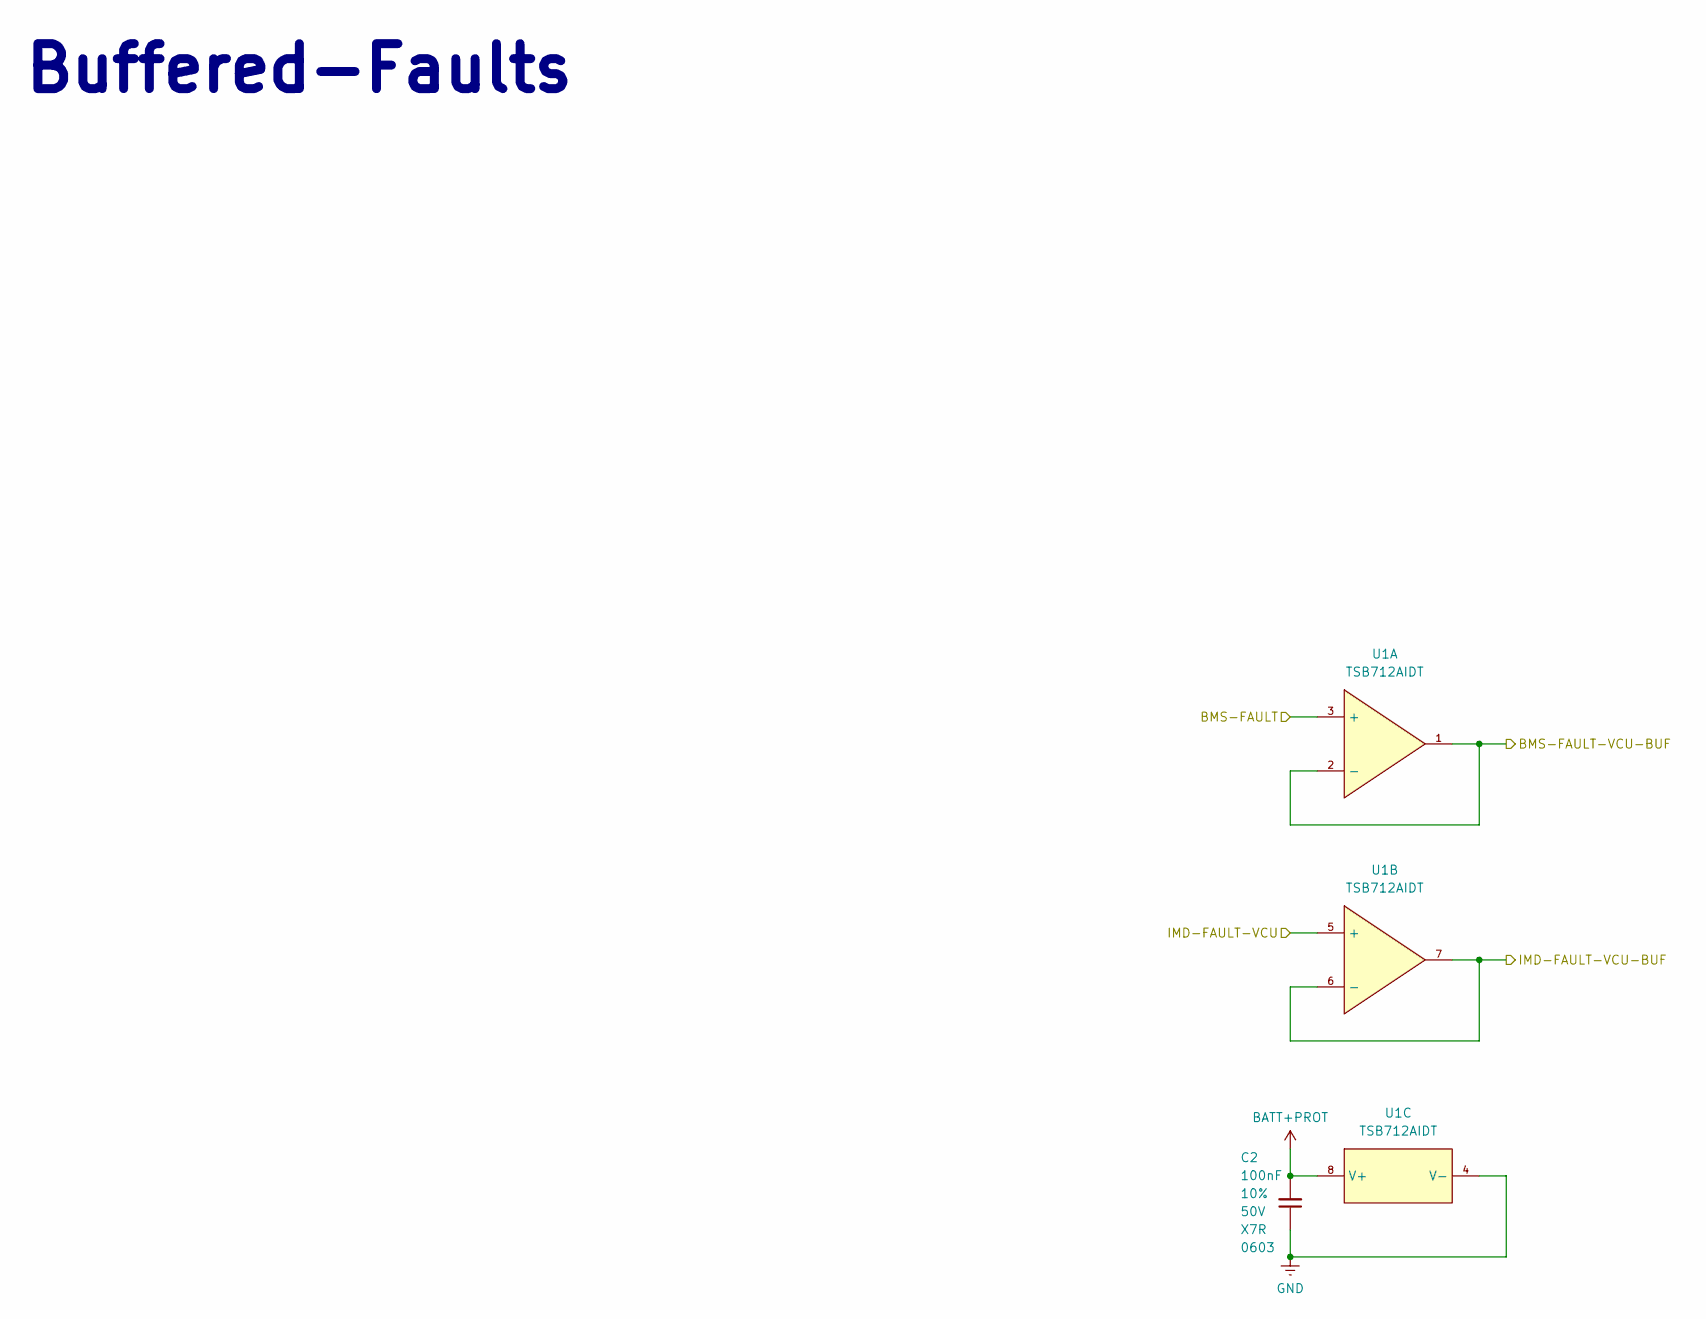
[picture p10: schematic Buffered-Faults.kicad_sch]

Parts:
C2: 100nF; C_0603_1608Metric_Pad1.08x0.95mm_HandSolder; Tolerance 10%; Voltage 50V; Manufacturer P/N CC0603KRX7R9BB104; Digikey P/N 311-1344-1-ND
U1: TSB712AIDT; SOIC-8_5.3x5.3mm_P1.27mm; Manufacturer P/N TSB712AIDT; Digikey P/N 497-19067-1-ND

Connections:
/BMS-FAULT: U1.3 (+); also elsewhere on the board
/BMS-FAULT-VCU-BUF: U1.1, U1.2 (-); also elsewhere on the board
/IMD-FAULT-VCU: U1.5 (+); also elsewhere on the board
/IMD-FAULT-VCU-BUF: U1.6 (-), U1.7; also elsewhere on the board
BATT+PROT: C2.2, U1.8 (V+); also elsewhere on the board
GND: C2.1, U1.4 (V-); also elsewhere on the board

Notes on the sheet:
Buffered-Faults

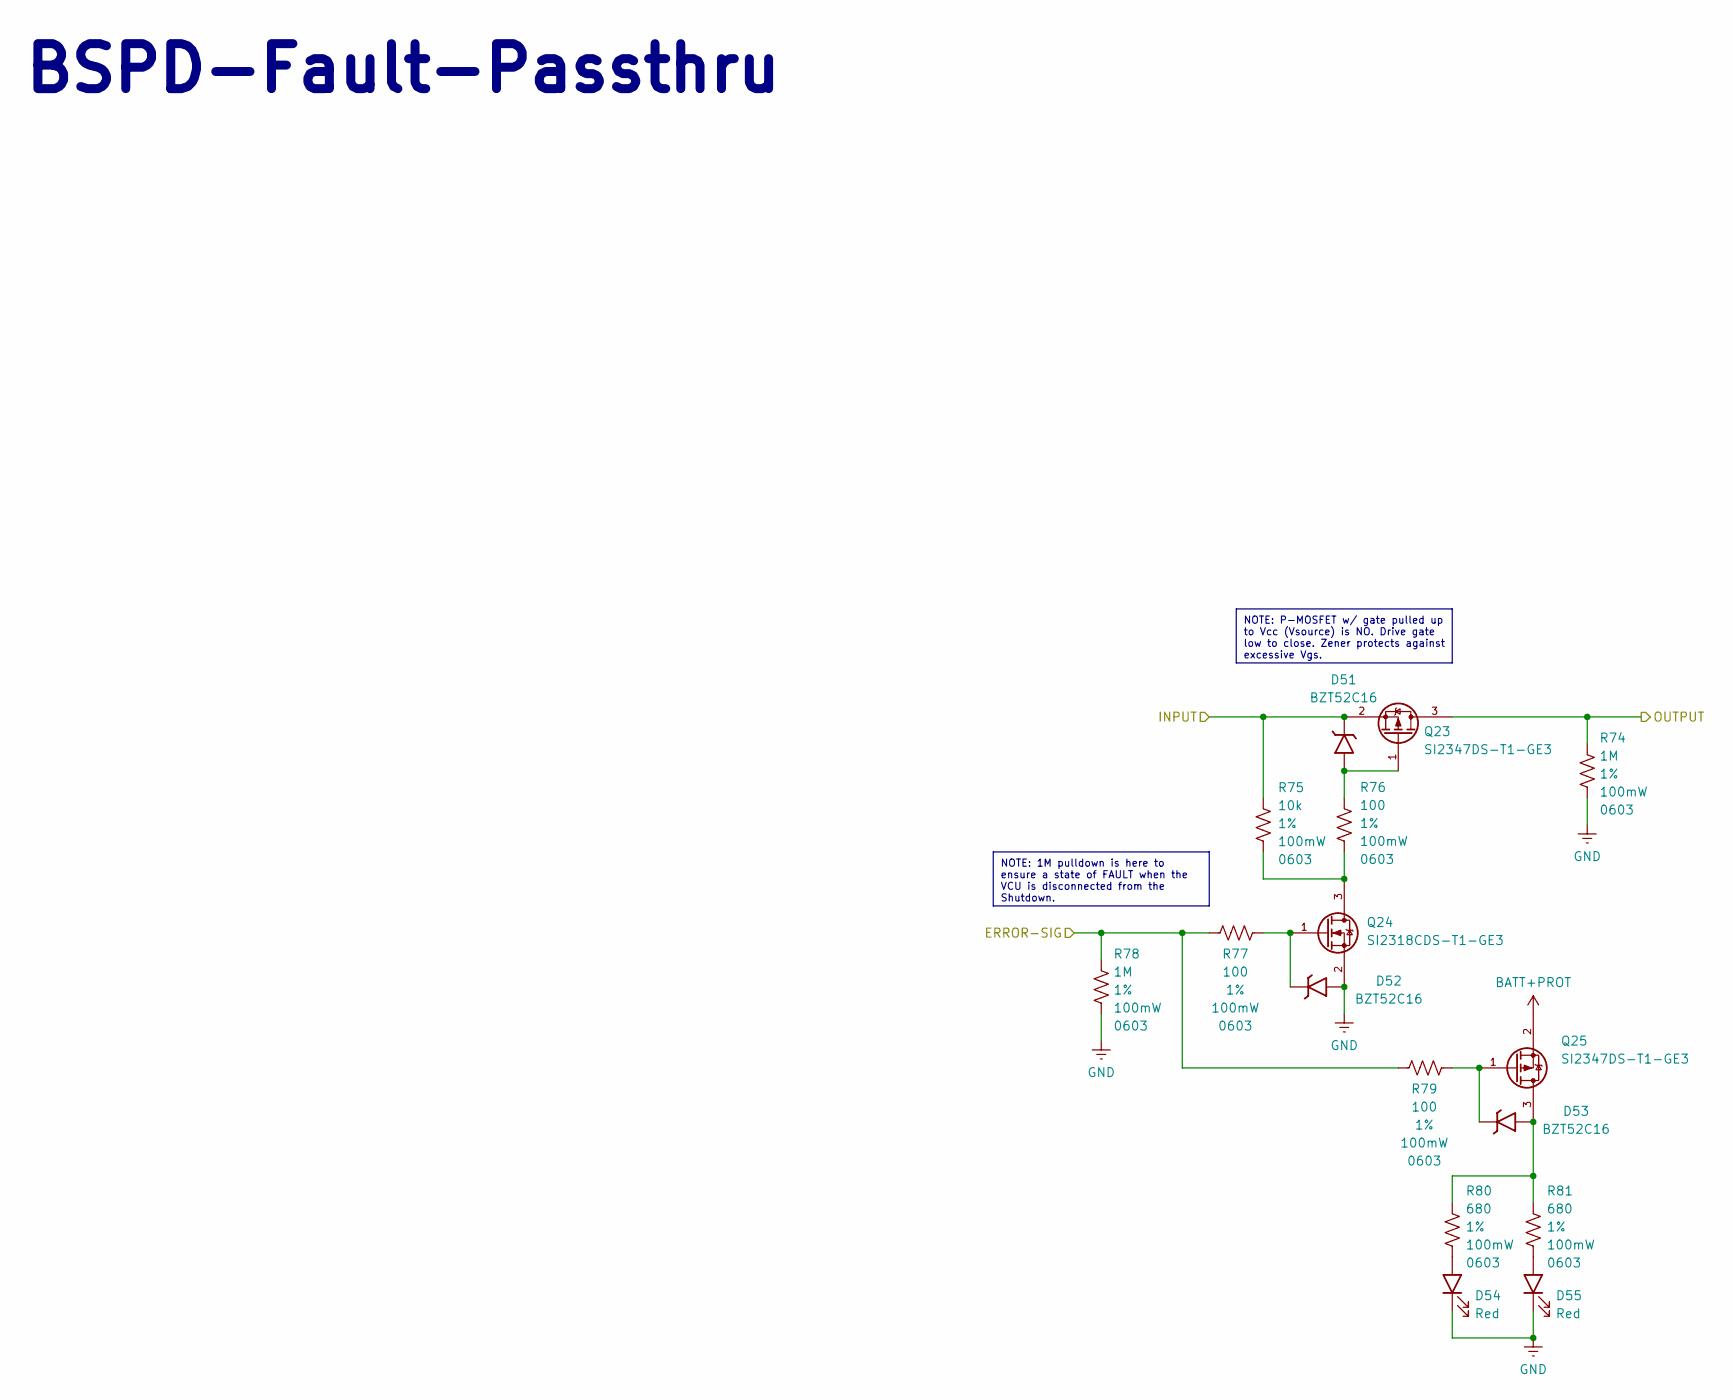
[picture p11: schematic BSPD-Fault-Passthru.kicad_sch]

Parts:
D51, D52, D53: BZT52C16; D_SOD-123; Manufacturer P/N BZT52C16; Digikey P/N 4878-BZT52C16CT-ND
D54, D55: Red; LED_0805_2012Metric; Manufacturer P/N NCD0805R1; Digikey P/N 160-1427-1-ND
Q23, Q25: SI2347DS-T1-GE3; SOT-23-3; Manufacturer P/N SI2347DS-T1-GE3; Digikey P/N SI2347DS-T1-GE3CT-ND
Q24: SI2318CDS-T1-GE3; SOT-23-3; Manufacturer P/N SI2318CDS-T1-GE3; Digikey P/N SI2318CDS-T1-GE3CT-ND
R74, R78: 1M; R_0603_1608Metric_Pad0.98x0.95mm_HandSolder; Tolerance 1%; Power Rating 100mW; Manufacturer P/N 0603WAF1004T5E; Digikey P/N YAG4498CT-ND
R75: 10k; R_0603_1608Metric_Pad0.98x0.95mm_HandSolder; Tolerance 1%; Power Rating 100mW; Manufacturer P/N 0603WAF1002T5E; Digikey P/N 541-10.0KHCT-ND
R76, R77, R79: 100; R_0603_1608Metric_Pad0.98x0.95mm_HandSolder; Tolerance 1%; Power Rating 100mW; Manufacturer P/N 0603WAF1000T5E; Digikey P/N 311-100HRCT-ND
R80, R81: 680; R_0603_1608Metric_Pad0.98x0.95mm_HandSolder; Tolerance 1%; Power Rating 100mW; Manufacturer P/N 0603WAF6800T5E; Digikey P/N 311-680GRCT-ND

Connections:
/BMS-Fault-Passthru/INPUT: Q23.3 (D), R74.2; also elsewhere on the board
/BSPD-FAULT-VCU: R77.1, R78.2, R79.1; also elsewhere on the board
BATT+PROT: D51.1 (K), Q23.2 (S), Q25.2 (S), R75.2; also elsewhere on the board
GND: D52.2 (A), D54.1 (K), D55.1 (K), Q24.2 (S), R74.1, R78.1; also elsewhere on the board
unnamed: D51.2 (A), Q23.1 (G), R76.2
unnamed: D52.1 (K), Q24.1 (G), R77.2
unnamed: D53.2 (A), Q25.3 (D), R80.2, R81.2
unnamed: D53.1 (K), Q25.1 (G), R79.2
unnamed: D54.2 (A), R80.1
unnamed: D55.2 (A), R81.1
unnamed: Q24.3 (D), R75.1, R76.1

Notes on the sheet:
BSPD-Fault-Passthru
NOTE: P-MOSFET w/ gate pulled up to Vcc (Vsource) is NO. Drive gate low to close. Zener protects against excessive Vgs.
NOTE: 1M pulldown is here to ensure a state of FAULT when the VCU is disconnected from the Shutdown.

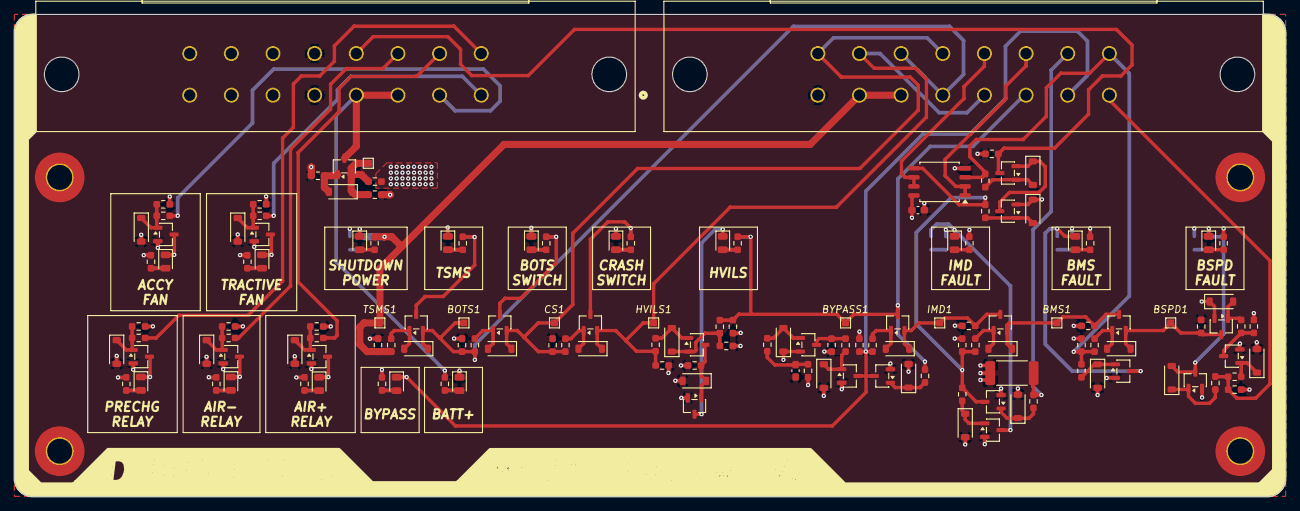
[picture p12: board Shutdown.kicad_pcb from above]

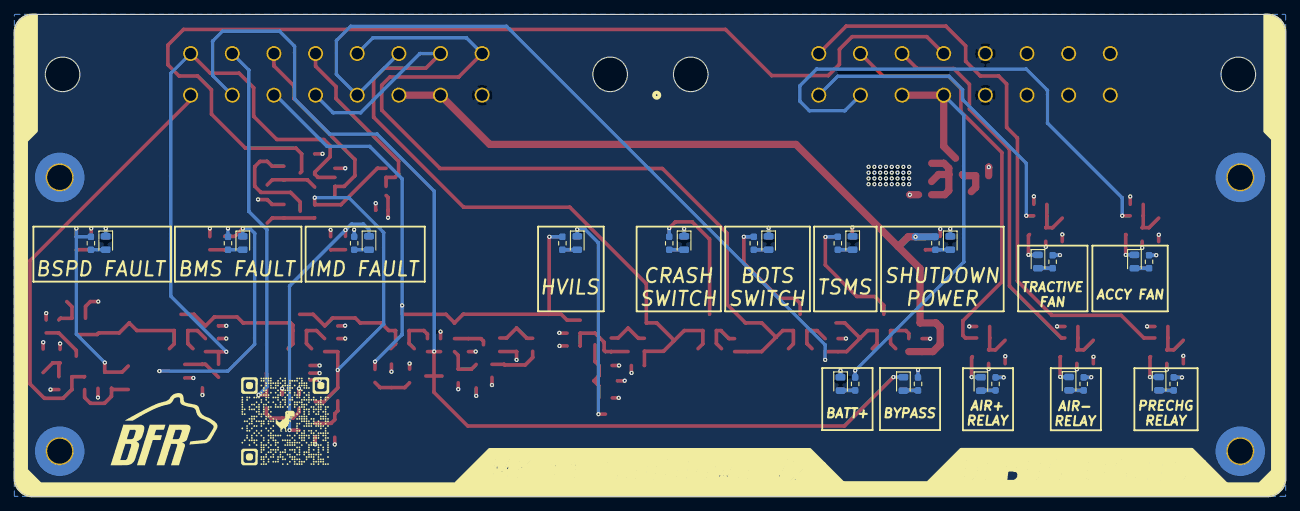
[picture p13: board Shutdown.kicad_pcb from below]

Board: 4 copper layers, 178.3 x 67.6 mm, 179 parts (30 on the bottom side), 97 nets.
