bruinformula/mk11-shutdown-pcb/(commit log)

2025-07-14 initial commit, mk10 shutdown but with updated schematics and added notes, same PCB
    [BSPD-Logic.kicad_sch, Fault-Passthru.kicad_sch, Indicator-Lights.kicad_sch, Shutdown.kicad_pcb, Shutdown.kicad_sch]
2025-10-08 completed schematic cleanup, back on 12V
    [348300801.stp, 348302001.stp, BSPD-Logic.kicad_sch, Buffered-Faults.kicad_sch, Fault-Passthru.kicad_sch, Input-Power.kicad_sch, Shutdown-Circuit.kicad_sch, Shutdown.kicad_sch]
2025-10-08 test push
    [Shutdown.kicad_pcb]
2025-10-09 another test
    [Buffered-Faults.kicad_sch, Shutdown.kicad_sch]
2025-10-09 i think it worked
    [Buffered-Faults.kicad_sch, Shutdown.kicad_sch]
2025-10-15 completed placement:
    [BSPD-Logic.kicad_sch, Buffered-Faults.kicad_sch, Fault-Passthru.kicad_sch, Indicator-Lights.kicad_sch, Shutdown-Circuit.kicad_sch, Shutdown.kicad_pcb, Shutdown.kicad_sch]
2026-02-07 changed BSPD, BMS fault logic to match Mk11 specs, all signals going back to VCU have 12V fault, 0V no fault readings, connector symbols/footprints left for next push
    [0194270049.stp, BSPD-Fault-Passthru.kicad_sch, Buffered-Faults.kicad_sch, Shutdown-MX150L.step, Shutdown.kicad_pcb, Shutdown.kicad_sch]
2026-02-07 nvm bms and imd are 12V fault, 0V no fault, only BSPD is 12V no fault, 0V fault going back to vcu rn
    [BSPD-Fault-Passthru.kicad_sch, Shutdown.kicad_sch]
2026-02-10 maintenance push
    [BSPD-Fault-Passthru.kicad_sch]
2026-02-10 added comments to TSSI light sheet
    [Indicator-Lights.kicad_sch]
2026-02-11 added in second connector for power, SD power, debug
    [Shutdown.kicad_sch]
2026-02-11 cleaning port names
    [Buffered-Faults.kicad_sch, Shutdown.kicad_sch]
2026-02-11 updating component properties
    [Shutdown.kicad_sch]
2026-02-11 updated port directionalities, updated pinout
    [BSPD-Fault-Passthru.kicad_sch, Buffered-Faults.kicad_sch, Fault-Passthru.kicad_sch, Indicator-Lights.kicad_sch, Shutdown-Circuit.kicad_sch, Shutdown.kicad_sch]
2026-02-13 Schem is reannotated time to redo all of the layout
    [BSPD-Fault-Passthru.kicad_sch, Buffered-Faults.kicad_sch, Fault-Passthru.kicad_sch, Indicator-Lights.kicad_sch, Shutdown-Circuit.kicad_sch, Shutdown.kicad_sch]
2026-02-13 Finished shutdown, 0 drc, need to export gerbers
    [BSPD-Fault-Passthru.kicad_sch, Buffered-Faults.kicad_sch, Fault-Passthru.kicad_sch, Indicator-Lights.kicad_sch, Shutdown-Circuit.kicad_sch, Shutdown.kicad_pcb, Shutdown.kicad_sch]
2026-02-13 EXPORTED Gerbers, fixed qr code
    [BOM-Shutdown.csv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]
2026-02-13 fixed silk and re-exported
    [Shutdown-CuBottom.gbr, Shutdown-CuIn1.gbr, Shutdown-CuIn2.gbr, Shutdown-CuTop.gbr, Shutdown-EdgeCuts.gbr, Shutdown-MaskBottom.gbr, Shutdown-MaskTop.gbr, Shutdown-NPTH.drl]
2026-05-03 added comments to add that for future revs there should be a pulldown between shutdown fault passthru stages
    [BSPD-Fault-Passthru.kicad_sch, Buffered-Faults.kicad_sch, Fault-Passthru.kicad_sch, Indicator-Lights.kicad_sch, Shutdown-Circuit.kicad_sch, Shutdown.kicad_sch]
2026-05-11 schematic updated to V2 extra crispy
    [BSPD-Fault-Passthru.kicad_sch, Buffered-Faults.kicad_sch, Debug-Lights.kicad_sch, Fault-Passthru.kicad_sch, Indicator-Lights.kicad_sch, Shutdown-Circuit.kicad_sch, Shutdown.kicad_pcb, Shutdown.kicad_sch]
2026-05-12 layout done extra crispy v2
    [Fault-Passthru.kicad_sch, Shutdown-Circuit.kicad_sch, Shutdown.kicad_pcb, Shutdown.kicad_sch, TSSI-Status-Signal.kicad_sch]
2026-05-12 rounded corners
    [Shutdown.kicad_pcb]
2026-05-12 Exported Gerbers
    [BOM-Shutdown.csv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]
